ATevera/r6g_steppermotor/Documentacion/Póster--Robot6GDL-Rev2.pdf

DIAGRAMA DE BLOQUES | ESQUEMA ELECTRÓNICO

# UNIVERSIDAD POLITÉCNICA DE CHIAPAS

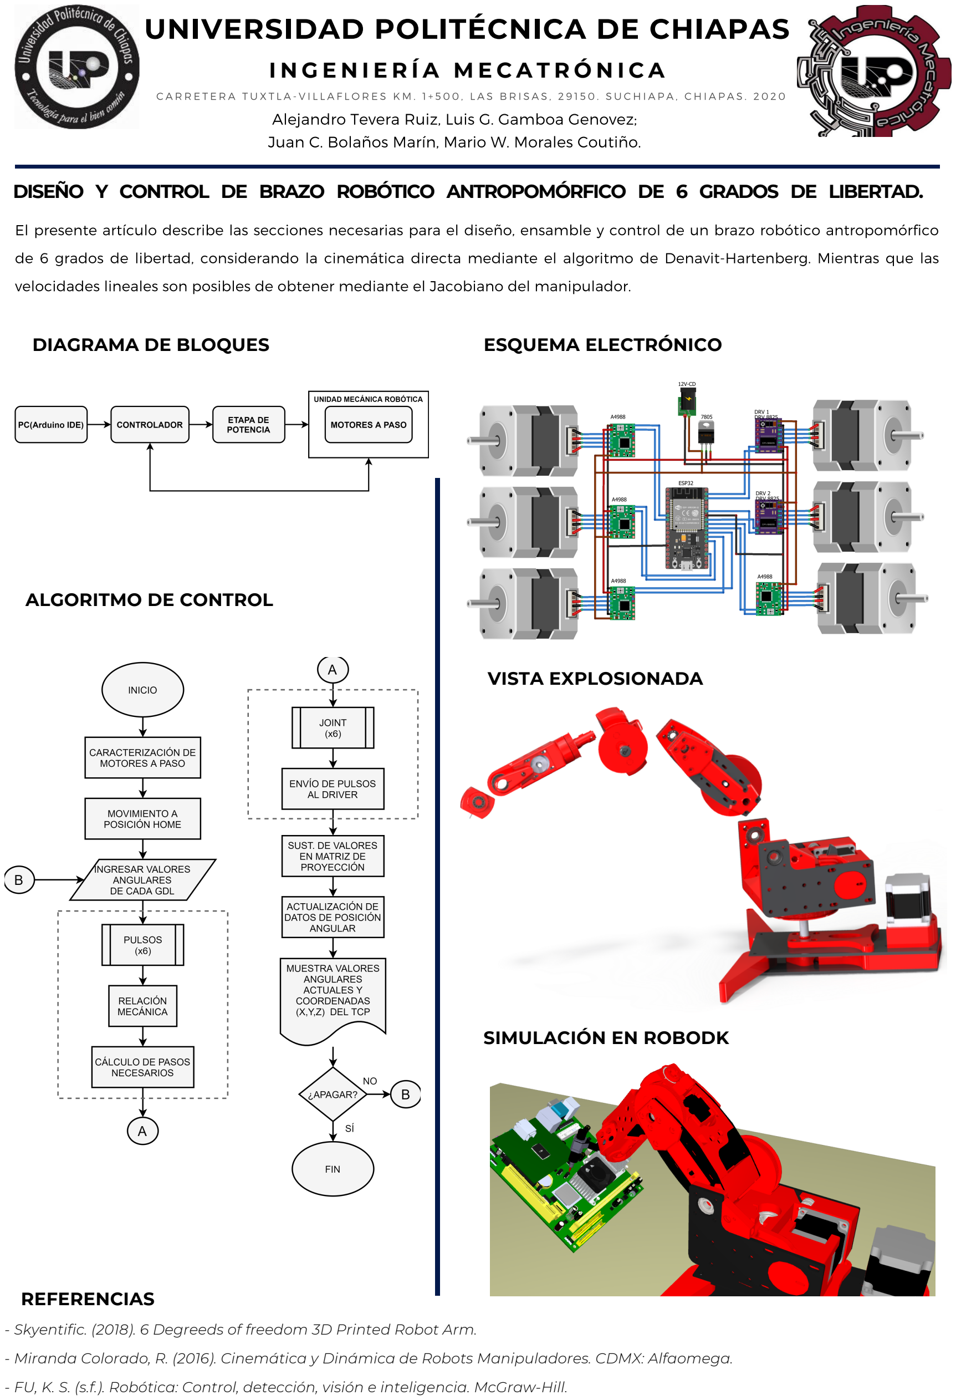
[picture p35: page 1]

# VISTA EXPLOSIONADA

### CINEMÁTICA Y DINÁMICA DIRECTA

# REFERENCIAS

# ALGORITMO DE CONTROL

# SIMULACIÓN EN ROBODK

Alejandro Tevera Ruiz, Luis G. Gamboa Genovez;

Juan C. Bolaños Marín, Mario W. Morales Coutiño.

# I N G E N I E R Í A M E C A T R Ó N I C A

C A R R E T E R A T U X T L A - V I L L A F L O R E S K M . 1 + 5 0 0 , L A S B R I S A S , 2 9 1 5 0 . S U C H I A P A , C H I A P A S . 2 0 2 0

DISEÑO Y CONTROL DE BRAZO ROBÓTICO ANTROPOMÓRFICO DE 6 GRADOS DE LIBERTAD.

El presente artículo describe las secciones necesarias para el diseño, ensamble y control de un brazo robótico antropomórfico

de 6 grados de libertad, considerando la cinemática directa mediante el algoritmo de Denavit-Hartenberg. Mientras que las

velocidades lineales son posibles de obtener mediante el Jacobiano del manipulador.

- Skyentific. (2018). 6 Degreeds of freedom 3D Printed Robot Arm.
- Miranda Colorado, R. (2016). Cinemática y Dinámica de Robots Manipuladores. CDMX: Alfaomega.
- FU, K. S. (s.f.). Robótica: Control, detección, visión e inteligencia. McGraw-Hill.

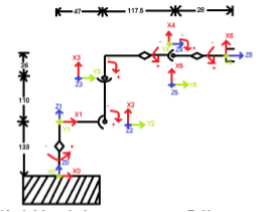
[picture p36: figure]

# JACOBIANO

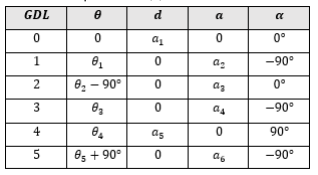
[picture p37: figure]

# REFERENCIAS

- Skyentific. (2018). 6 Degreeds of freedom 3D Printed Robot Arm.

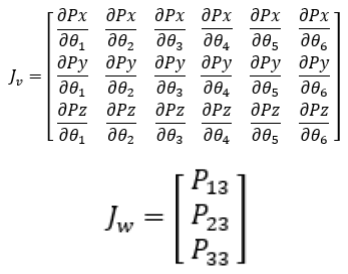
[picture p38: figure]
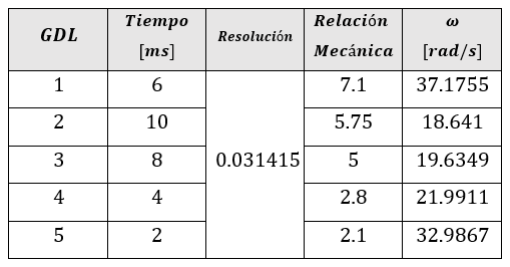
[picture p39: figure]
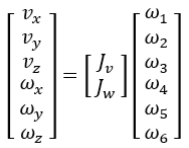
[picture p40: figure]

- Miranda Colorado, R. (2016). Cinemática y Dinámica de Robots Manipuladores. CDMX: Alfaomega.

# UNIVERSIDAD POLITÉCNICA DE CHIAPAS

CÁLCULO DE POSICIÓN, VELOCIDADES LINEALESY ANGULARES DE UN MANIPULADOR DE6 GDL.

El presente artículo describe la cinemática directa mediante el algoritmo de Denavit-Hartenberg y las velocidades lineales y

angulares del TCP (Tool Center Point) mediante la matriz Jacobiana.

Introducción: El modelo cinemático directo consiste en calcular

la posición del efector final con base a los ángulos otorgados de

cada grado de libertad del brazo robótico.

El objeto de estudio es un manipulador de 6 GDL, con

eslabones definidos por a1, a2, a3, a4, a5, a6 y grados de libertad

rotacionales: ϴ1, ϴ2. ϴ3, ϴ4, ϴ5.

Resolviendo el producto de las matrices de cada sistema de

referencia, es posible obtener la matriz de transformación

homogénea denotada de la siguiente forma:

Alejandro Tevera Ruiz, Luis G. Gamboa Genovez;

Juan C. Bolaños Marín, Mario W. Morales Coutiño.

Para continuar | con | el algoritmo, se obtiene la tabla de

parámetros del manipulador (1),

Realizando una matriz por cada articulación con los parámetros

de la tabla anterior (1) como se muestra a continuación (2).

Para conocer la posición en X, Y, Z del efector final se usan las

ecuaciones PX, PY, PZ obtenidas de (3).

# I N G E N I E R Í A M E C A T R Ó N I C A

C A R R E T E R A T U X T L A - V I L L A F L O R E S K M . 1 + 5 0 0 , L A S B R I S A S , 2 9 1 5 0 . S U C H I A P A , C H I A P A S . 2 0 2 0

(2)

(1)

(4)

(5)

(6)

(3)

Introducción: La matriz Jacobiana nos permite conocer las

velocidades angulares y lineales del TCP en función de las

velocidades angulares de cada grado de libertad.

Para | obtener | la | matriz | Jacobiana | de | velocidad | lineal | y

velocidad angular, se considera respectivamente:

(7)

Las velocidades angulares características de este manipulador

son las siguientes.

(8)

(9)

Para obtener la matriz Jacobiana se realiza el producto de las

matrices de velocidad lineal (7) y angular (8) con las velocidades

angulares del manipulador (9).

(10)
