ATevera/r6g_steppermotor/Documentacion/Sistema Operativo Robótico (ROS) - Póster.pdf

# SISTEMA OPERATIVO ROBÓTICO ( R O S )

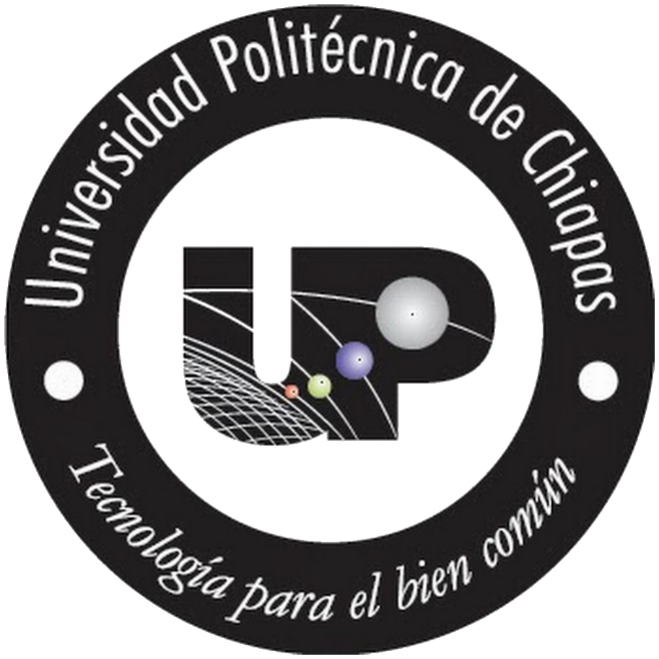
[picture p41: figure]
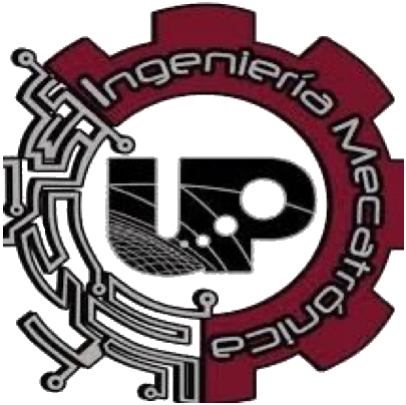
[picture p42: figure]

1. Departamento de Ingeniería Mecatrónica, Universidad Politécnica de Chiapas, Suchiapa 29150, México

TEVERA-RUIZ A , MORALES-COUTIÑO M .
1 1

### Introducción

Dado el interés incremental en la construcción, diseño y control de robots comerciales y no comerciales, es necesaria la estandarización de su arquitectura para permitir colaboraciones efectivas con el equipo de trabajo, así como desarrollar sistemas complejos a partir de pequeños scripts con base a diversas herramientas y bibliotecas de código abierto para un avance en robótica sustancial en todo el mundo.

### Entorno

Abstracción de hardware.
Control de dispositivos de bajo nivel.
Comunicación entre procesos mediante mensajes. Mantenimiento de paquetes.

Ubuntu
Debian
Fedora
Raspbian

Mac OS X
Microsoft Windows

Aunque su nombre lo indique, ROS es un sistema meta-operativo que permite las principales funcionalidades de un sistema operativo convencional:

Su desarrollo está centrado en sistemas GNU/LINUX, principalmente para las distribuciones más reconocidas:

Sin embargo, su popularidad ha permitido su adaptación experimental en sistemas operativos más comerciales:

### Arquitectura

Nodos - Scripts para el procesamiento de datos para su emisión (nodo publicador) o solicitud (nodo suscriptor).
Temas - Clasificación de los mensajes.
Mensajes - Datos para la comunicación unidireccional entre nodos.
Servicios - Datos para la comunicación bidireccional entre nodos.
Paquetes - Centralización de nodos para una tarea. Stacks - Integración de paquetes para la ejecución de proyectos muy complejos.

Está basado en una aquitectura de grafos con los siguientes elementos:

Visión Artificial
Inteligencia Artificial
Simulación y visualización 3D en tiempo real Geolocalización
Control de actuadores
Planificación de movimiento Reconocimiento de voz

Mediante su versatilidad es sencillo implementar diversas áreas en un mismo robot:

### Aplicaciones

Desarrollar sistemas de control avanzados mediante la deconstrucción de etapas de funcionamiento. Escalabilidad del proyecto.
Distribución y colaboración adecuada para grandes equipos de trabajo.
Independencia de lenguaje, permitiendo programar en Python, C++ o Lisp.
Integración con placas de desarrollo comerciales.

En función a la gran variedad de herramientas y librerías, ROS oferta un ambiente de trabajo para proyectos de robótica completo y muy eficiente, permitiendo:

### Ventajas

### Conclusión

La implementación de ROS en proyectos escolares permite el fortalecimiento de conocimientos adquiridos mediante el desarrollo de proyectos más elaborados considerando una estandarización para cada etapa y un progreso simultáneo en todo el equipo de trabajo. Además, permite aprovechar las especificaciones de placas educativas, como Arduino, al reducir la carga de procesamiento; enfocándose en la administración de señales.

Documentation - ROS Wiki. (2020). Disponible en http://wiki.ros.org/

### REFERENCIA
