ATevera/r6g_steppermotor/Documentacion/PinOut Arnés-Conector.xlsx

Sheet: NOMENCLATURA DE CABLES
ORDEN DE BOBINAS
ARTICULACIÓN | BOBINA | CABLE | ARTICULACIÓN | BOBINA | CABLE
J1 | A | NEGRO(NARANJA) | J4 | A | NEGRO
 |  | VERDE(AZUL) |  |  | VERDE
 | B | ROJO |  | B | ROJO
 |  | AMARILLO |  |  | AMARILLO(AZUL)
J2 | A | NEGRO(NARANJA) | J5 | A | NEGRO
 |  | VERDE(AZUL) |  |  | VERDE
 | B | ROJO |  | B | ROJO
 |  | AMARILLO |  |  | AMARILLO(AZUL)
J3 | A | NEGRO | J6 | A | NEGRO
 |  | VERDE |  |  | VERDE
 | B | ROJO |  | B | ROJO
 |  | AMARILLO(AZUL) |  |  | AMARILLO(AZUL)

Sheet: DB25 ROBOT
CONECTOR DB25 - VISTA FRONTAL
P1 | P2 | P3 | P4 | P5 | P6 | P7 | P8 | P9 | P10 | P11 | P12 | P13
BJ1 | BJ1 | AJ1 | AJ1 | BJ2 | BJ2 | X | AJ2 | AJ2 | BJ3 | BJ3 | AJ3 | AJ3
P14 | P15 | P16 | P17 | P18 | P19 |  | P20 | P21 | P22 | P23 | P24 | P25
BJ4 | BJ4 | AJ4 | AJ4 | BJ5 | BJ5 |  | AJ5 | AJ5 | BJ6 | BJ6 | AJ6 | AJ6
 | Error en J1 - Rojo
 | Error en J2 - Amarillo

Sheet: Drivers
Articulación | StepperMotor | Driver | Rs | Imax | Vref
J1 | NEMA23 | DRV8825 | 0.1 | 1.3 | 0.65
J2 | NEMA23 | DRV8825 | 0.1 | 2 | 1
J3 | NEMA17 | A4988 | 0.1 | 1 | 0.8
J4 | NEMA11 | A4988 | 0.1 | 0.67 | 0.536
J5 | NEMA11 | A4988 | 0.1 | 0.67 | 0.536
J6 | NEMA8 | A4988 | 0.1 | 0.6 | 0.48
