ATevera/r6g_steppermotor/(commit log)

2020-11-22 Pose inicial
    [poses.csv]
2020-11-22 Generación CSV
    [poses.csv]
2020-11-24 Consulta de última pose en CSV
2020-11-26 Detector de objetos
2020-11-27 Transferencia de perspectiva
2020-11-28 Fix: Mostrar ventana OpenCV
    [DetectorObjetos.py]
2020-11-28 UP: Dimensiones espacio de trabajo
2020-11-30 Fix: Límite superior J5
    [r6g_steppermotor.urdf]
2020-11-30 Add: Pose de reconocimiento
2020-11-30 Fix: Pose de reconociento
    [DetectorObjetos.py]
2020-11-30 Fix: Ajuste error Eje Y
    [DetectorObjetos.py]
2020-12-01 Up: Mensajes r6g frame
2020-12-01 Fix: Pasos en J5
    [BootEsp32.ino]
2020-12-01 Fix: Construcción de mensaje para detección
    [DetectorObjetos.py]
2020-12-02 Fix: Control por visión artificial
    [CinematicaInversa.py, DetectorObjetos.py]
2020-12-14 Archivos de cierre
    [PinOut Arnés-Conector.xlsx]
2020-12-14 Archivos PCB Control y Potencia
